Bossama/H-Bridge-DC-motor-PID-regulator-control-based-on-BeagleBone-Black-Processing-Real-Time-Unit/shema_HBRIDGE1.png

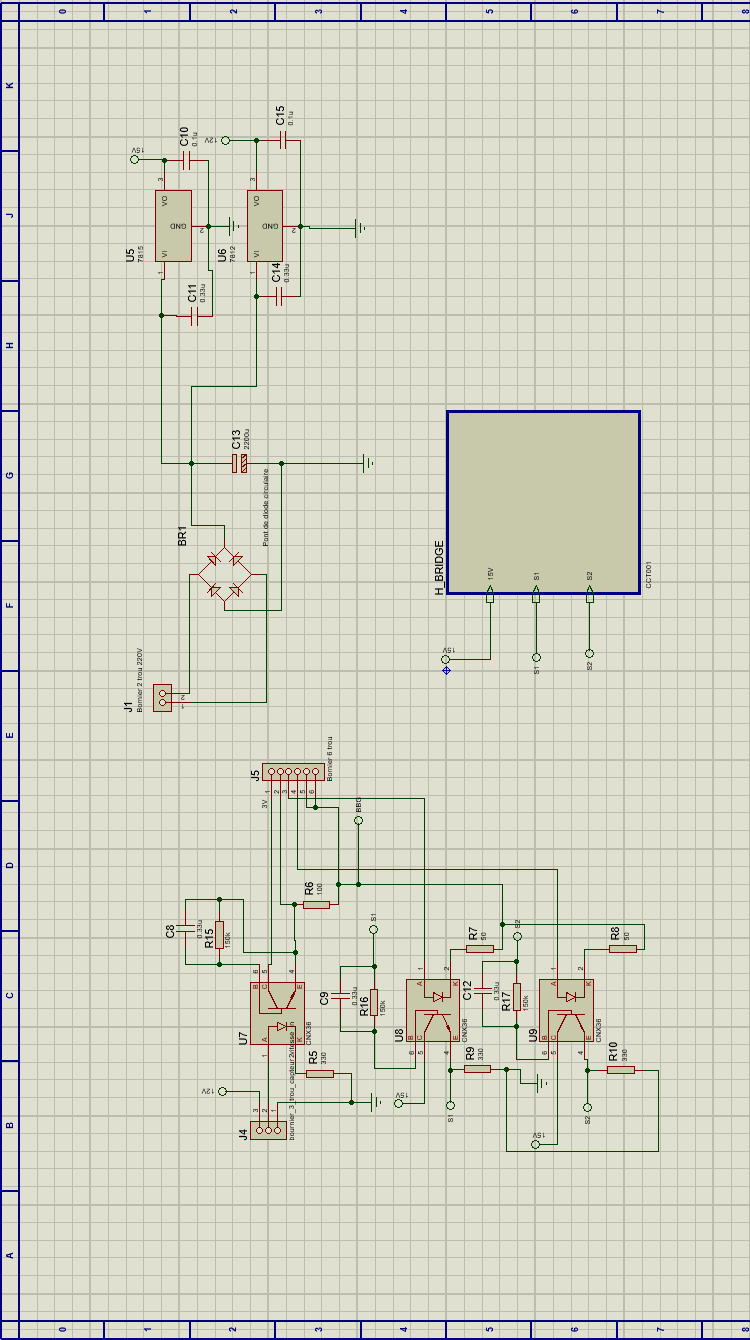
shema_HBRIDGE1.png
