Bossama/H-Bridge-DC-motor-PID-regulator-control-based-on-BeagleBone-Black-Processing-Real-Time-Unit/shema_HBRIDGE2.png

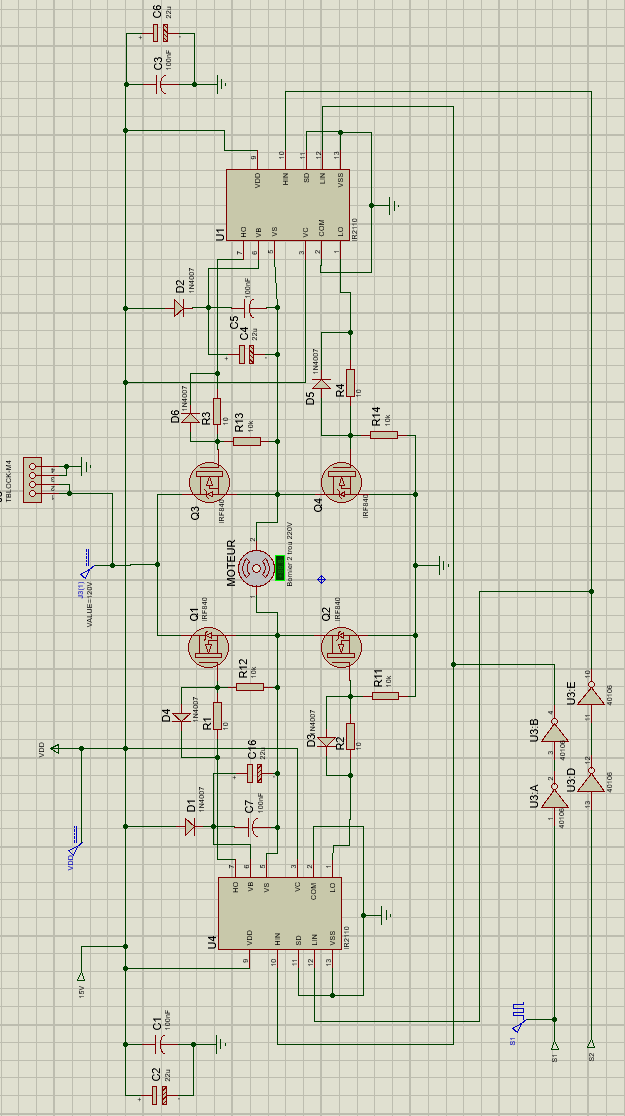
shema_HBRIDGE2.png
