Bossama/H-Bridge-DC-motor-PID-regulator-control-based-on-BeagleBone-Black-Processing-Real-Time-Unit/(list of files, drawings)

Other design files:
Routagel-H_bridge_IRF840.pdsprj
